NAMDH0415/MOSFET-bss138--IV-measurement/docs/multimeter-validation.md

# 드레인 전류 대조 기록

- 측정 날짜
- 사용 보드 및 MOSFET · NUCLEO-L432KC, BSS138
- 펌웨어 커밋 또는 버전
- 멀티미터 모델 및 DC 전압 범위
- 10 kΩ 저항의 실측값 `R` · 10.01 kΩ
- STM32 측정 CSV 파일명

게이트와 드레인 쪽 공급 전압을 측정 지점마다 고정합니다. 멀티미터는 DC 전압 모드로 두고, 빨간 프로브는 저항의 공급 쪽(A1), 검은 프로브는 드레인 쪽(A0)에 연결합니다. 저항 양단의 전압차와 같은 조건에서 읽은 STM32의 `ID_uA`를 기록합니다.

[모드 0·3 통합 측정표](results/multimeter-comparison.md)

- **멀티미터 기준 전류 (µA)** = 저항 양단 전압차 (V) × 1,000 ÷ 실측 저항값 (kΩ)
- **절대 차이 (µA)** = |STM32 전류 − 멀티미터 기준 전류|

예를 들어 실측 저항이 10.00 kΩ이고 저항 양단 전압차가 0.800 V이면, 멀티미터 기준 전류는 80.0 µA입니다.
