NAMDH0415/MOSFET-bss138--IV-measurement/docs/results/multimeter-comparison.md

# BSS138 멀티미터 검증 결과

NUCLEO-L432KC, BSS138, 10 kΩ 부하로 모드 3을 실행했습니다. 펌웨어는 ADC·DAC DMA 적용 버전(제공된 기록의 커밋 `909b854`)입니다. 게이트는 0–3.0 V로 스윕했고 각 공급 설정에서 게이트 3.0 V 끝부분의 값을 읽었습니다. Fluke 17B+의 DC 4.000 V 범위에서 빨간 프로브를 A1, 검은 프로브를 A0에 대고 저항 양단 전압을 측정했습니다. 전류 모드의 직렬 삽입에 따른 전압 강하를 피하기 위해 이 전압을 실측 저항 10.01 kΩ으로 나눴습니다. STM32는 ADC로 읽은 전압차를 코드의 10.00 kΩ으로 나눕니다.

## BSS138 모델 계산

Diodes Incorporated가 공개한 Zetex BSS138 SPICE 모델 v2.0에서 `VTO = 1.0 V`, `KP = 0.395 A/V²`, `LAMBDA = 0.000267 V⁻¹`, 내부 소스 저항 `RS = 1.58 Ω`, 드레인–소스 병렬 저항 `RL = 6 MΩ`을 사용했습니다. 사용한 실물의 제조사와 개체 파라미터는 확인되지 않았으므로 이 계산은 공개 모델에 대한 대표 예측입니다. onsemi 데이터시트의 최대 온저항 6 Ω은 게이트 4.5 V, 전류 0.22 A 조건에서 명시됩니다. [Diodes/Zetex BSS138 모델](https://www.diodes.com/spice/download/1838/BSS138.spice.txt) · [onsemi BSS138 데이터시트](https://www.onsemi.com/download/data-sheet/pdf/bss138-d.pdf)

게이트를 3.0 V로 고정하고 공급 설정마다 아래 식을 동시에 만족하는 전류를 이분법으로 구했습니다. `V_D`는 외부 드레인 전압, `v_DS`와 `v_GS`는 내부 소스 저항의 강하를 반영한 채널 전압입니다. 정적 끝점에서 채널과 6 MΩ 경로를 계산에 포함했고, 역방향 다이오드의 미소 전류와 커패시턴스는 생략했습니다.

```text
V_D = VSupply_Set − I_D × 10010 Ω
I_D = I_channel + V_D / 6 MΩ
v_GS = 3.0 V − I_channel × 1.58 Ω
v_DS = V_D − I_channel × 1.58 Ω
I_channel = KP × [(v_GS − VTO) × v_DS − v_DS² / 2] × (1 + LAMBDA × v_DS)
```

계산된 외부 드레인 전압은 **0.199–0.796 mV**입니다. 네 조건 모두 내부 `v_DS`가 양수이고 `v_GS − VTO`보다 작아 선형 영역 식을 적용했습니다. 공급 2.8 V에서 모델은 **279.64 µA**, 드레인 전압을 0 V로 둔 부하 근사는 **279.72 µA**입니다. 약 **0.08 µA**의 차이는 이 조건에서 10.01 kΩ 저항이 전류를 크게 제한한다는 점을 보여줍니다.

## 모드 3 끝점 비교

| 공급 설정 (V) | Fluke 전압차 (V) | BSS138 모델 예측 (µA) | STM32 CSV (µA) | 오차율 (모델 기준) | 멀티미터(Fluke 17B+) 측정 (µA) | 성능 비교 (멀티미터 기준) | Fluke 전압 사양만 | 전압·저항 사양 반영 범위 (µA) |
| ---: | ---: | ---: | ---: | ---: | ---: | ---: | ---: | ---: |
| 0.7 | 0.706 | 69.91 | 70.19 | 0.39% | 70.53 | 0.49% | ±0.92% | 69.39–71.68 |
| 1.4 | 1.408 | 139.82 | 140.10 | 0.20% | 140.66 | 0.39% | ±0.71% | 138.69–142.66 |
| 2.1 | 2.112 | 209.73 | 210.22 | 0.23% | 210.99 | 0.37% | ±0.64% | 208.18–213.84 |
| 2.8 | 2.815 | 279.64 | 280.21 | 0.20% | 281.22 | 0.36% | ±0.61% | 277.57–284.92 |

**오차율** = |STM32 전류 − 모델 예측 전류| ÷ 모델 예측 전류 × 100. **성능 비교** = `|STM32 전류 − 멀티미터 기준 전류|` ÷ 멀티미터 기준 전류 × 100.

### Fluke 측정 범위와 해석

DC 4.000 V 범위의 분해능은 1 mV이며 정확도 한계는 `ΔV = 0.005 × 표시값 + 0.003 V`입니다. 예를 들어 2.815 V에서 전압 한계는 ±17.08 mV입니다. 저항도 같은 Fluke의 40.00 kΩ 범위에서 측정했다고 가정하면 `ΔR = 0.005 × 10.01 + 0.02 = 0.07005 kΩ`입니다. 마지막 열은 두 한계를 동시에 적용한 최악조건 범위 `(V−ΔV)/(R+ΔR)`부터 `(V+ΔV)/(R−ΔR)`까지를 µA로 나타냈습니다. 이 범위에는 STM32 오차나 스윕 간 변동이 포함되어 있지 않습니다. Fluke 사양은 교정 후 1년 이내, 18–28 °C, 상대습도 0–75% 조건입니다. 실제 저항 측정 범위와 교정 상태는 확인되지 않았습니다. [Fluke 17B+ 공식 사양](https://www.fluke.com/en-us/product/electrical-testing/digital-multimeters/fluke-17b-plus)

STM32 끝점 전류는 멀티미터 측정 기준 전류보다 0.36–0.49% 낮았습니다. 네 차이는 전압 측정 사양만 반영한 한계(약 0.61–0.92%)보다 작았습니다. 다만 STM32는 11월 12일 CSV의 `point_index=127`, Fluke는 11월 13일의 별도 스윕이므로 이 차이만으로 어느 계측값이 더 정확한지 판단할 수 없습니다.

### 기준 전압과 반복성

3V3와 AREF는 모두 3.324 V로 읽혔습니다. 실제 ADC 기준이 3.324 V라면, 코드의 3.300 V 가정은 전압차를 약 0.72% 낮게 계산합니다. 실측 10.01 kΩ 대신 10.00 kΩ을 사용하는 효과까지 합치면 전류는 약 0.62% 낮아지는 방향입니다. Fluke로 읽은 3.324 V에는 전압 사양상 약 ±19.62 mV의 한계가 있어 원인은 확정할 수 없습니다.

제공된 측정 기록에서 모드 0의 점 300–511 평균은 11월 12일 **280.14 µA**, 11월 13일 **280.16 µA**였습니다. 두 평균의 차이는 약 0.007%입니다. 11월 13일 평균은 같은 날 모드 3의 Fluke 281.22 µA보다 약 0.38% 낮았습니다. 두 모드는 별도 실행입니다.

## 모드 0 참고 측정

공급 설정 2.8 V에서 Fluke로 읽은 값입니다. 중간점은 실제 게이트 전압과 샘플 번호가 미기록입니다. 이전 CSV의 167번(18.7010 µA)은 전류가 가장 가까운 행이며, 표에는 멀티미터 관측값만 기록했습니다.

| 지점 | 저항 양단 전압 (V) | 멀티미터(Fluke 17B+) 측정 (µA) |
| --- | ---: | ---: |
| 시작 | 0 | 0.00 |
| 중간 | 0.189 | 18.88 |
| 끝 | 2.804 | 280.12 |

## 추가 검증이 필요한 경우

모드 3 끝점 비교는 드레인 전압이 거의 0 V인 조건을 다룹니다. 전류가 급하게 변하는 구간이나 A0의 중간 전압에서 정량적인 오차를 확인하려면 게이트와 공급 전압을 고정하고, Fluke 전압차와 STM32의 실측 전압·전류를 같은 시점에 기록합니다. 기록상 DAC의 저전압 구간에서는 ADC가 약 0.042 V를 읽었으며, 외부 계측으로 확인하려면 공급 설정 0 V에서 실제 출력 전압을 따로 잽니다.

[측정 펌웨어 커밋](https://github.com/NAMDH0415/MOSFET-bss138--IV-measurement/commit/909b8545743f1aec5a040b975a6f15212145258d) · [11월 12일 모드 3 CSV](mode-3-transfer-by-supply.csv)
