NAMDH0415/MOSFET-bss138--IV-measurement/docs/results/mode-0-transfer.csv

VGS_Set | VGS_Measured | VSupply | VDrain | ID_uA | time_ms | sample_id | sweep_id | point_index
0.000000 | 0.04190 | 2.80429 | 2.80329 | 0.1007 | 2387854 | 0 | 1 | 0
0.005871 | 0.04190 | 2.80404 | 2.80309 | 0.0957 | 2388033 | 1 | 1 | 1
0.011742 | 0.04170 | 2.80440 | 2.80288 | 0.1511 | 2388213 | 2 | 1 | 2
0.017613 | 0.04140 | 2.80414 | 2.80299 | 0.1158 | 2388393 | 3 | 1 | 3
0.023483 | 0.04175 | 2.80424 | 2.80299 | 0.1259 | 2388573 | 4 | 1 | 4
0.029354 | 0.04190 | 2.80399 | 2.80238 | 0.1612 | 2388753 | 5 | 1 | 5
0.035225 | 0.04160 | 2.80424 | 2.80278 | 0.1461 | 2388933 | 6 | 1 | 6
0.041096 | 0.04236 | 2.80445 | 2.80293 | 0.1511 | 2389113 | 7 | 1 | 7
0.046967 | 0.04820 | 2.80374 | 2.80258 | 0.1158 | 2389293 | 8 | 1 | 8
0.052838 | 0.05404 | 2.80384 | 2.80258 | 0.1259 | 2389473 | 9 | 1 | 9
0.058708 | 0.05973 | 2.80379 | 2.80288 | 0.0906 | 2389653 | 10 | 1 | 10
0.064579 | 0.06522 | 2.80389 | 2.80268 | 0.1209 | 2389833 | 11 | 1 | 11
0.070450 | 0.07046 | 2.80369 | 2.80243 | 0.1259 | 2390013 | 12 | 1 | 12
0.076321 | 0.07726 | 2.80384 | 2.80278 | 0.1058 | 2390193 | 13 | 1 | 13
0.082192 | 0.08331 | 2.80324 | 2.80228 | 0.0957 | 2390373 | 14 | 1 | 14
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
