NAMDH0415/MOSFET-bss138--IV-measurement/docs/results/mode-1-output.csv

VGS_Set | VGS_Measured | VSupply_Set | VSupply | VDS_Measured | ID_uA | time_ms | sample_id | sweep_id | point_index
1.000000 | 0.99967 | 0.000000 | 0.04145 | 0.00358 | 3.7875 | 2260308 | 0 | 1 | 0
1.000000 | 1.00068 | 0.005479 | 0.04130 | 0.00519 | 3.6113 | 2260489 | 1 | 1 | 1
1.000000 | 1.00118 | 0.010959 | 0.04135 | 0.00408 | 3.7271 | 2260671 | 2 | 1 | 2
1.000000 | 1.00043 | 0.016438 | 0.04120 | 0.00383 | 3.7372 | 2260853 | 3 | 1 | 3
1.000000 | 1.00007 | 0.021918 | 0.04095 | 0.00378 | 3.7170 | 2261035 | 4 | 1 | 4
1.000000 | 1.00043 | 0.027397 | 0.04085 | 0.00383 | 3.7019 | 2261217 | 5 | 1 | 5
1.000000 | 0.99987 | 0.032877 | 0.04105 | 0.00403 | 3.7019 | 2261399 | 6 | 1 | 6
1.000000 | 0.99987 | 0.038356 | 0.04135 | 0.00393 | 3.7422 | 2261581 | 7 | 1 | 7
1.000000 | 1.00002 | 0.043836 | 0.04593 | 0.00433 | 4.1603 | 2261763 | 8 | 1 | 8
1.000000 | 0.99952 | 0.049315 | 0.05158 | 0.00499 | 4.6589 | 2261945 | 9 | 1 | 9
1.000000 | 1.00017 | 0.054795 | 0.05727 | 0.00630 | 5.0971 | 2262127 | 10 | 1 | 10
1.000000 | 1.00012 | 0.060274 | 0.06281 | 0.00740 | 5.5403 | 2262309 | 11 | 1 | 11
1.000000 | 0.99992 | 0.065753 | 0.06820 | 0.00806 | 6.0137 | 2262491 | 12 | 1 | 12
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
