NAMDH0415/MOSFET-bss138--IV-measurement/docs/results/mode-2-output-by-gate.csv

VGS_Set | VGS_Measured | VSupply_Set | VSupply | VDS_Measured | ID_uA | time_ms | sample_id | sweep_id | point_index
0.900000 | 0.90065 | 0.000000 | 0.04165 | 0.02231 | 1.9341 | 2151763 | 0 | 1 | 0
0.900000 | 0.90050 | 0.022047 | 0.04125 | 0.02236 | 1.8887 | 2151944 | 1 | 1 | 1
0.900000 | 0.90030 | 0.044094 | 0.04679 | 0.02569 | 2.1103 | 2152126 | 2 | 1 | 2
0.900000 | 0.90045 | 0.066142 | 0.06840 | 0.04281 | 2.5586 | 2152308 | 3 | 1 | 3
0.900000 | 0.90025 | 0.088189 | 0.09031 | 0.06120 | 2.9112 | 2152490 | 4 | 1 | 4
0.900000 | 0.90005 | 0.110236 | 0.11292 | 0.08210 | 3.0824 | 2152672 | 5 | 1 | 5
0.900000 | 0.90045 | 0.132283 | 0.13458 | 0.10325 | 3.1328 | 2152854 | 6 | 1 | 6
0.900000 | 0.90055 | 0.154331 | 0.15699 | 0.12531 | 3.1680 | 2153036 | 7 | 1 | 7
0.900000 | 0.90055 | 0.176378 | 0.17890 | 0.14667 | 3.2234 | 2153218 | 8 | 1 | 8
0.900000 | 0.90045 | 0.198425 | 0.20101 | 0.16782 | 3.3191 | 2153400 | 9 | 1 | 9
0.900000 | 0.90020 | 0.220472 | 0.22312 | 0.19084 | 3.2285 | 2153582 | 10 | 1 | 10
0.900000 | 0.90005 | 0.242520 | 0.24513 | 0.21245 | 3.2688 | 2153764 | 11 | 1 | 11
0.900000 | 0.90035 | 0.264567 | 0.26669 | 0.23335 | 3.3342 | 2153946 | 12 | 1 | 12
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
