NAMDH0415/MOSFET-bss138--IV-measurement/docs/results/mode-3-transfer-by-supply.csv

VGS_Set | VGS_Measured | VSupply | VDrain | ID_uA | time_ms | sample_id | sweep_id | point_index
0.000000 | 0.04226 | 0.70150 | 0.70080 | 0.0705 | 2028728 | 0 | 1 | 0
0.023622 | 0.04145 | 0.70196 | 0.70049 | 0.1461 | 2028907 | 1 | 1 | 1
0.047244 | 0.04765 | 0.70190 | 0.70039 | 0.1511 | 2029087 | 2 | 1 | 2
0.070866 | 0.07147 | 0.70185 | 0.70125 | 0.0604 | 2029267 | 3 | 1 | 3
0.094488 | 0.09489 | 0.70206 | 0.70039 | 0.1662 | 2029447 | 4 | 1 | 4
0.118110 | 0.11902 | 0.70160 | 0.70090 | 0.0705 | 2029627 | 5 | 1 | 5
0.141732 | 0.14279 | 0.70196 | 0.70080 | 0.1158 | 2029807 | 6 | 1 | 6
0.165354 | 0.16596 | 0.70206 | 0.70075 | 0.1310 | 2029987 | 7 | 1 | 7
0.188976 | 0.19013 | 0.70175 | 0.70039 | 0.1360 | 2030167 | 8 | 1 | 8
0.212598 | 0.21345 | 0.70201 | 0.70034 | 0.1662 | 2030347 | 9 | 1 | 9
0.236220 | 0.23551 | 0.70190 | 0.70054 | 0.1360 | 2030527 | 10 | 1 | 10
0.259843 | 0.26014 | 0.70160 | 0.69979 | 0.1813 | 2030707 | 11 | 1 | 11
0.283465 | 0.28381 | 0.70145 | 0.70075 | 0.0705 | 2030887 | 12 | 1 | 12
0.307087 | 0.30779 | 0.70170 | 0.70160 | 0.0101 | 2031067 | 13 | 1 | 13
0.330709 | 0.33065 | 0.70170 | 0.70049 | 0.1209 | 2031247 | 14 | 1 | 14
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
