NAMDH0415/MOSFET-bss138--IV-measurement/MOSFET_BSS138_IV_measurement.ioc

Mcu.UserName=STM32L432KCUx
PA0.Signal=ADCx_IN5
PA1.Signal=GPIO_Analog
PA2.Signal=USART2_TX
PA3.Signal=GPIO_Analog
PA4.Signal=COMP_DAC11_group
PA5.Signal=COMP_DAC12_group
