NAMDH0415/MOSFET-bss138--IV-measurement/(commit log)

2026-11-12 Run VDS-ID sweep at one fixed gate voltage
    [vds_sweep_app.c]
2026-11-12 Document measurement voltage choices
2026-11-12 Add UART-controlled sweeps and ADC/DAC DMA
2026-11-12 Remove pre-DMA measurement screenshot
2026-11-12 Add clear BSS138 wiring schematic
2026-11-12 Add perfboard layout alongside circuit schematic
2026-11-12 Publish four BSS138 measurement CSVs and analysis
    [mode-0-transfer.csv, mode-1-output.csv, mode-2-output-by-gate.csv, mode-3-transfer-by-supply.csv]
2026-11-13 Summarize Fluke validation and theoretical current comparison
2026-11-13 Show assembled BSS138 measurement board
